surviveak/H2C-Top-Cover/stl/v1.7/H2C_TopCover_Center_Junction_Support_v1.7.stl

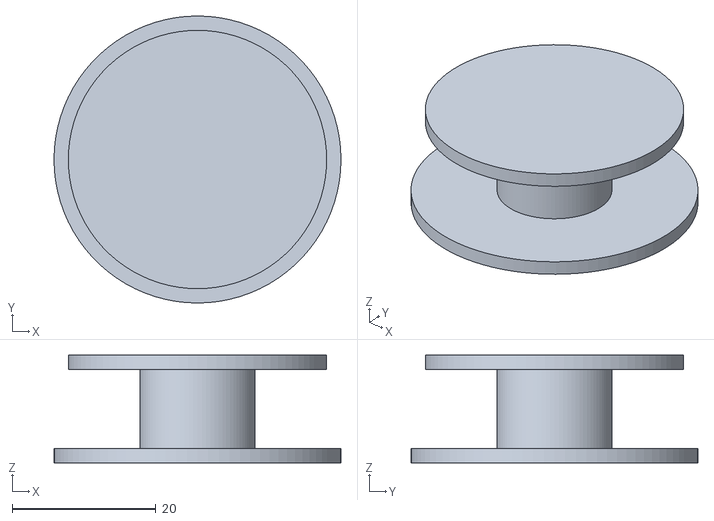
[picture p1: CAD file, 2026-10-05]
stl/v1.7/H2C_TopCover_Center_Junction_Support_v1.7.stl
40.0 x 40.0 x 15.0
