surviveak/H2C-Top-Cover/stl/v1.7/H2C_TopCover_Front_Left_v1.7.stl

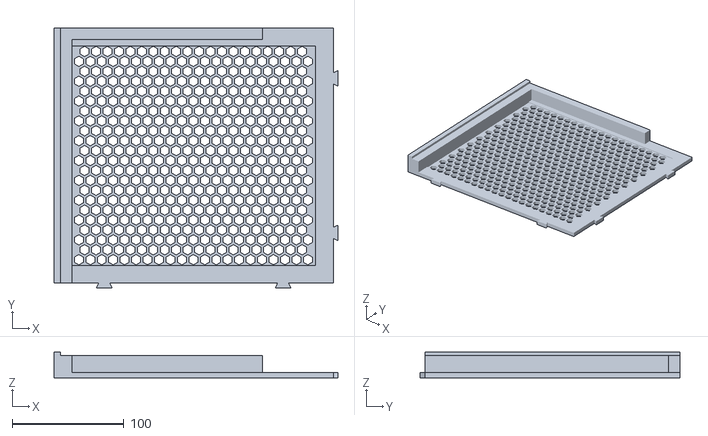
[picture p2: CAD file, 2026-10-05]
stl/v1.7/H2C_TopCover_Front_Left_v1.7.stl
254.2 x 232.5 x 23.0
