surviveak/H2C-Top-Cover/stl/v1.7/H2C_TopCover_Honeycomb_Clip_Support_v1.7.stl

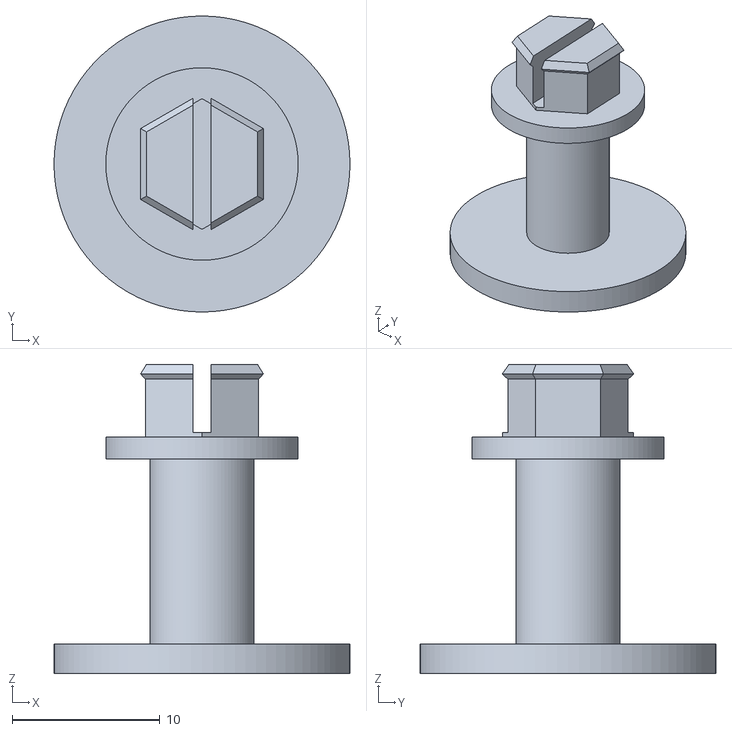
[picture p3: CAD file, 2026-10-05]
stl/v1.7/H2C_TopCover_Honeycomb_Clip_Support_v1.7.stl
20.0 x 20.0 x 20.9
