surviveak/H2C-Top-Cover/stl/v1.7/H2C_TopCover_Rear_Left_v1.7.stl

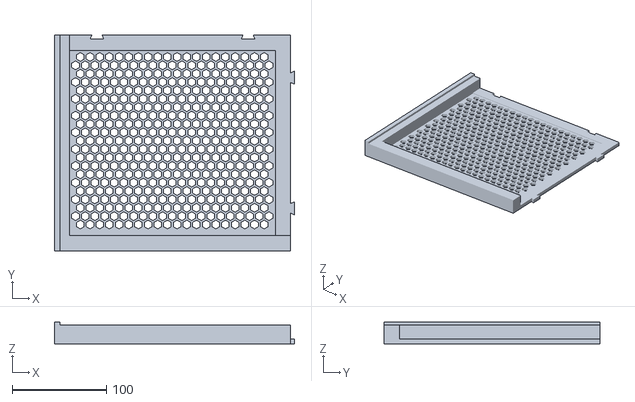
[picture p4: CAD file, 2026-10-05]
stl/v1.7/H2C_TopCover_Rear_Left_v1.7.stl
254.2 x 228.4 x 23.0
