surviveak/H2C-Top-Cover/(list of files, cad)

Other CAD files:
stl/v1.7/H2C_TopCover_Front_Right_v1.7.stl
stl/v1.7/H2C_TopCover_Rear_Right_v1.7.stl
