surviveak/H2C-Top-Cover/(commit log)

2026-10-05 Publish v1.7 panels oriented top-side down, supports and build source
    [H2C_TopCover_Center_Junction_Support_v1.7.stl, H2C_TopCover_Front_Left_v1.7.stl, H2C_TopCover_Front_Right_v1.7.stl, H2C_TopCover_Honeycomb_Clip_Support_v1.7.stl, H2C_TopCover_Rear_Left_v1.7.stl, H2C_TopCover_Rear_Right_v1.7.stl]
2026-10-05 Add prominent dimension verification note before printing
